tkoecker/v4_hid_wrapper/(commit log)

2020-05-02 added version for composite USB mouse+keyboard devices
2020-05-25 added note about needed sparkfun avr boards version
2020-05-25 added link/info for 3d printed case
